kurosawa467/Smart-Glove-Control-System/Reports and Documents/Edge_Computing_Project_Interim_Demo.pdf

# Smart Glove Control System

### Team 2 - Ata Gün Öğün - Charles Donven - Yucong Ma

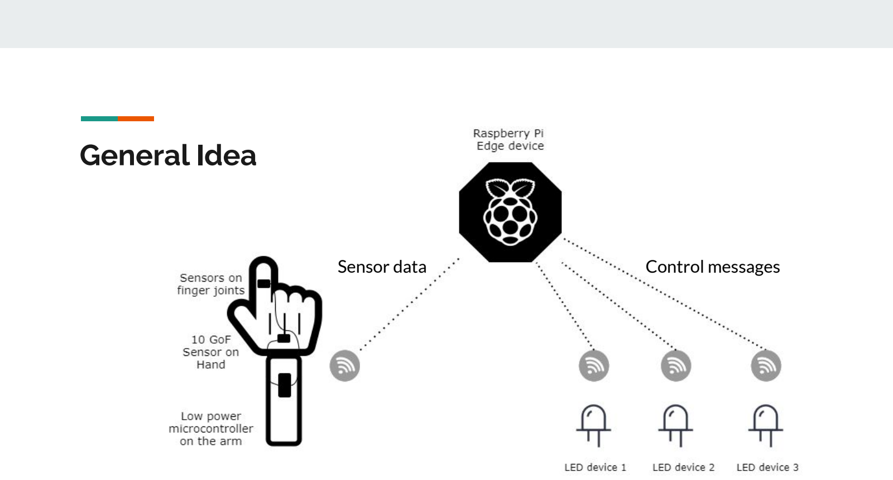
[picture p13: page 2]

Sensor data | Control messages

# General Idea

Cleaned up the code to better reflect the data flow we have in mind.

Implemented basic hard coded gestures for the demo.

Tested latency, fixed MQTT problems.

# What we have done

Implemented mock IoT LED devices which can receive commands via MQTT.

3D printed parts for mounting the flex sensors. Decided to sew them onto the glove instead.

Mounted the IMU to the glove internally, to avoid cutting the pins and doing solder work.

# 3D Printed Parts

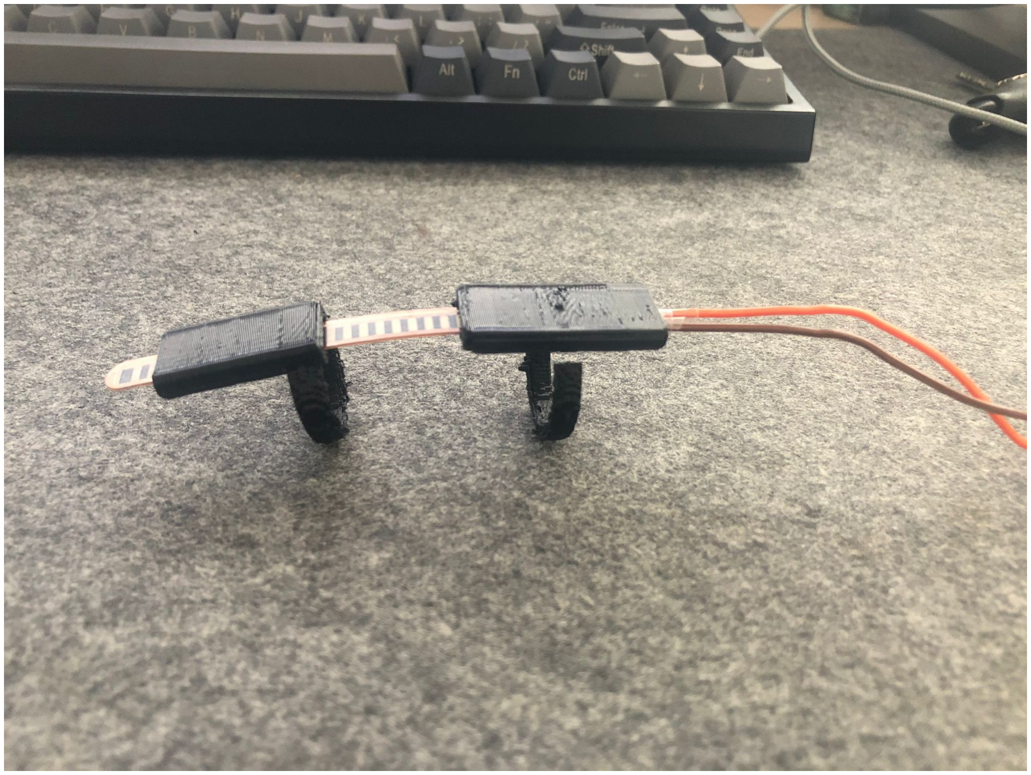
[picture p14: figure]

# Why we won’t use 3D Printed Parts

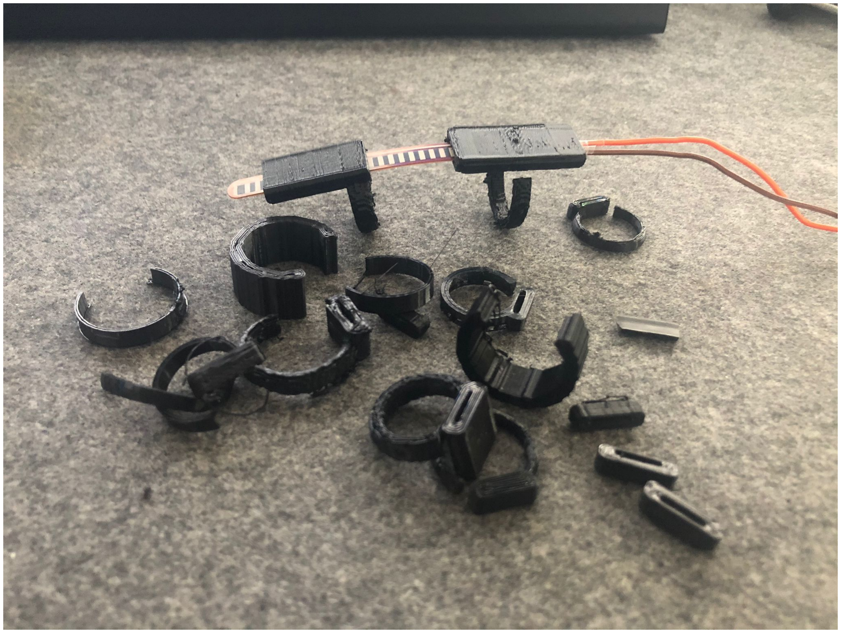
[picture p15: figure]

Most prints failed halfway.

Only one “successful” print after 9 tries.

Makes wearing the glove really complicated.

Uncomfortable to wear, restricts movement.

Harder to bend compared to our current design.

# Why we won’t use 3D Printed Parts

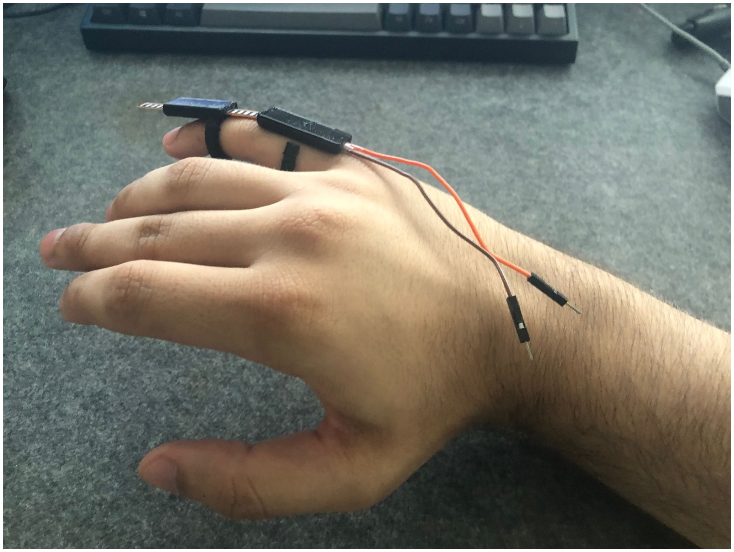
[picture p16: figure]

Most prints failed halfway.

Only one “successful” print after 9 tries.

Makes wearing the glove really complicated.

Uncomfortable to wear, restricts movement.

Harder to bend compared to our current design.

# Why we won’t use 3D Printed Parts

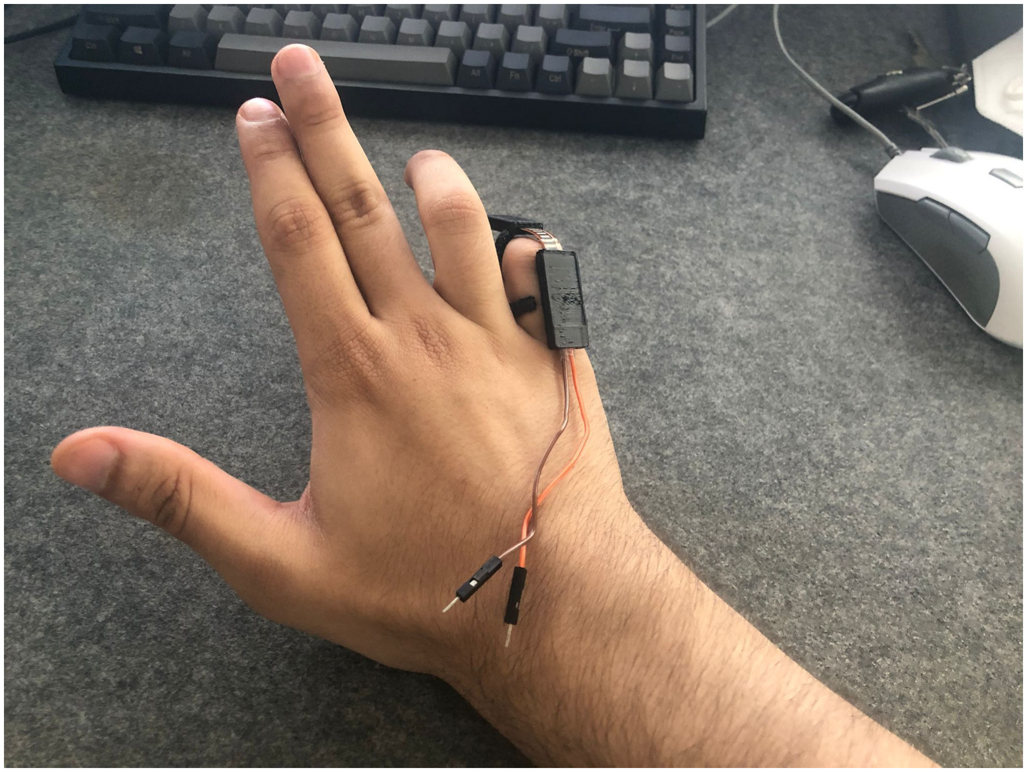
[picture p17: figure]

Most prints failed halfway.

Only one “successful” print after 9 tries.

Makes wearing the glove really complicated.

Uncomfortable to wear, restricts movement.

Harder to bend compared to our current design.

# Live demo

# Future work

Add a machine learning unit to process the commands coming from the glove

Add other devices to control

Generalize the method to add new objects to the system

# Thank you!

# Questions?
