kurosawa467/Smart-Glove-Control-System/Reports and Documents/Edge_Computing_Final_Presentation.pdf

# Smart Glove Control System

# Final Presentation

### Team 2 - Ata Gün Öğün - Charles Donven - Yucong Ma

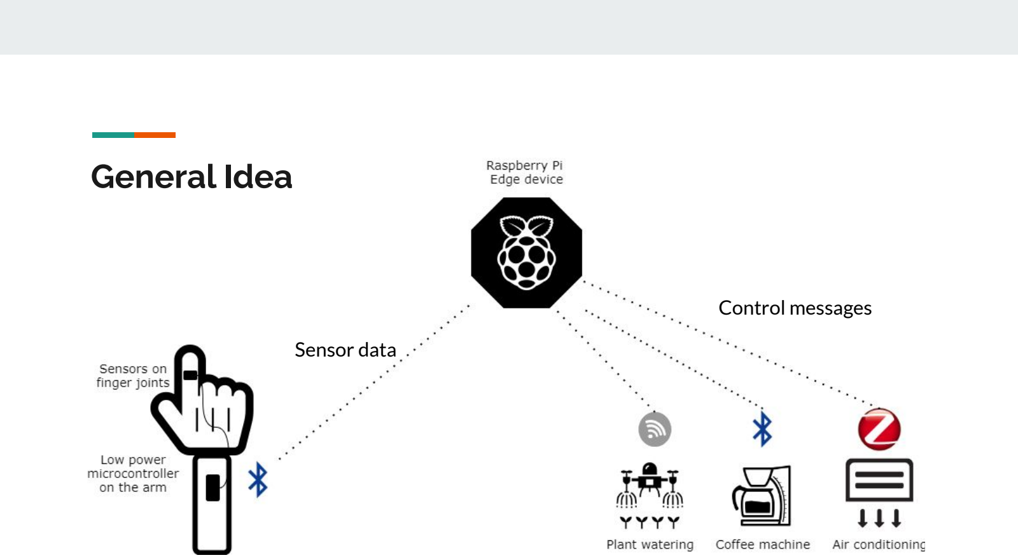
[picture p18: page 2]

# General Idea

Sensor data

Control messages

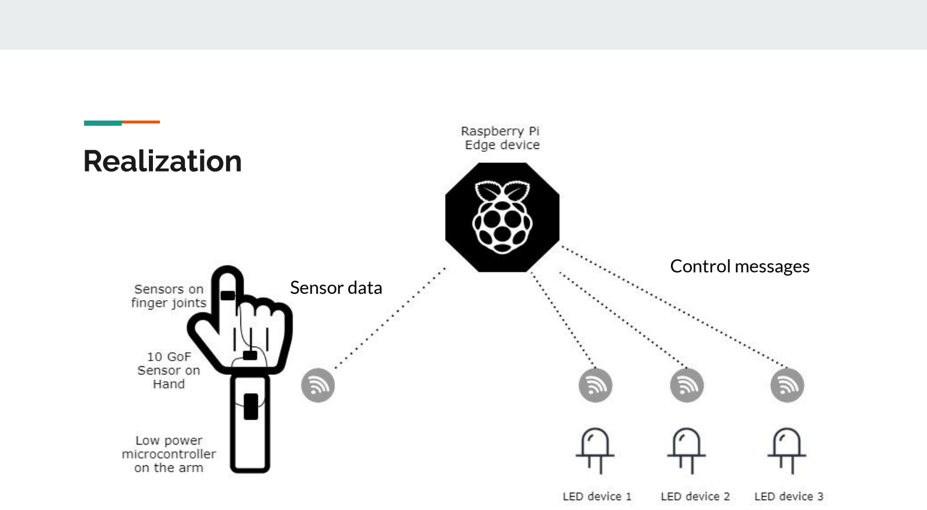
[picture p19: page 3]

# Realization

Sensor data

Control messages

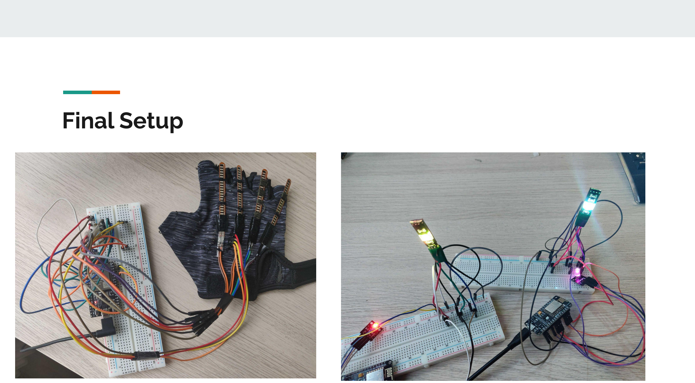
[picture p20: page 4]

# Final Setup

# Architecture Diagram

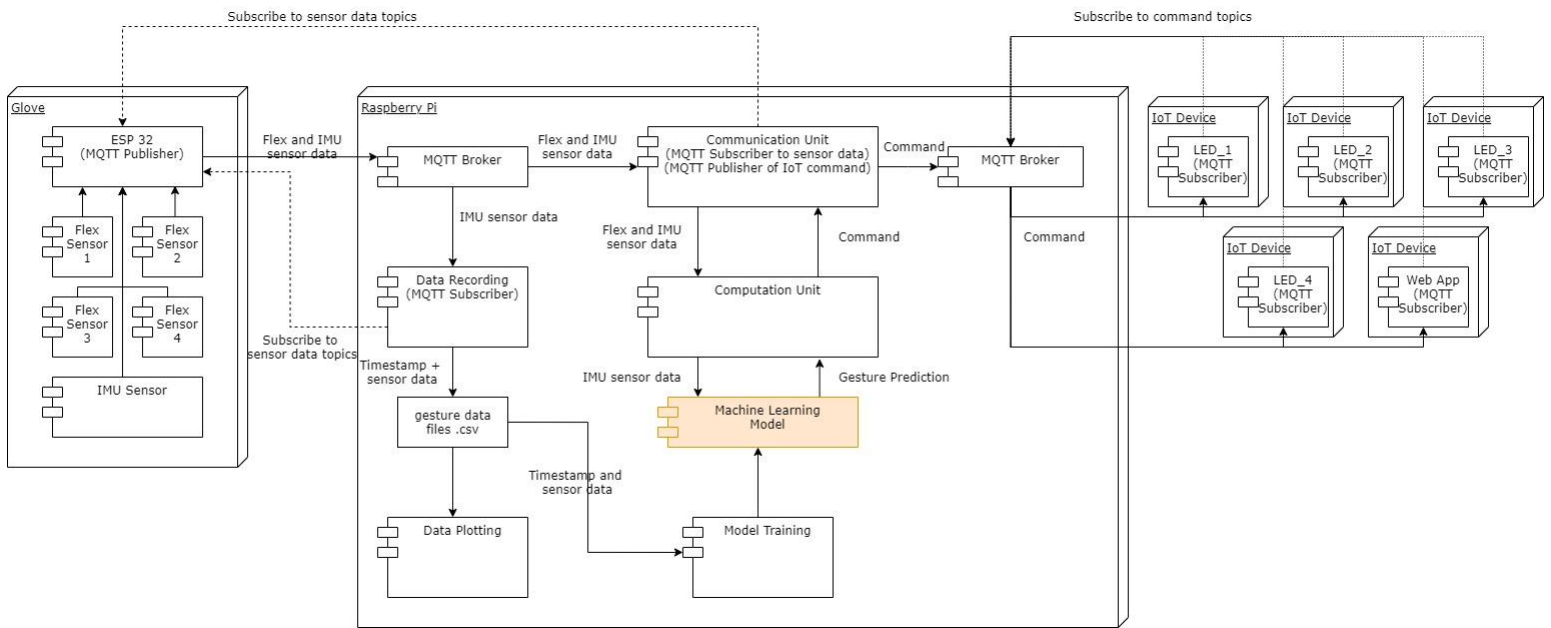
[picture p21: figure]

# Architecture Diagram: Application

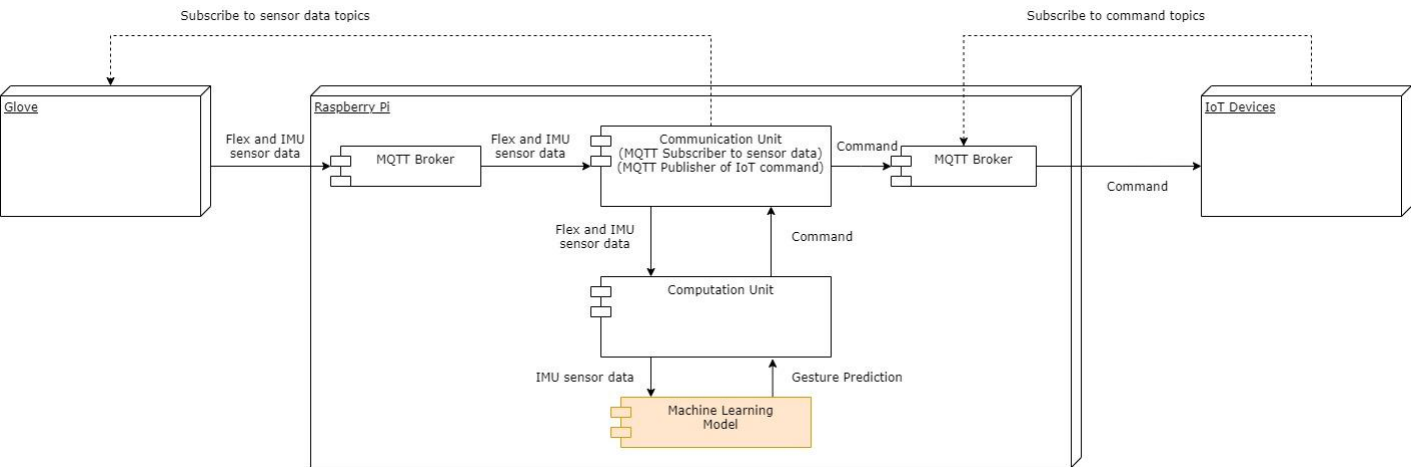
[picture p22: figure]

# Messaging Protocol: MQTT

- Publisher-Subscriber pattern, subject based
- Reliability
- Scalability

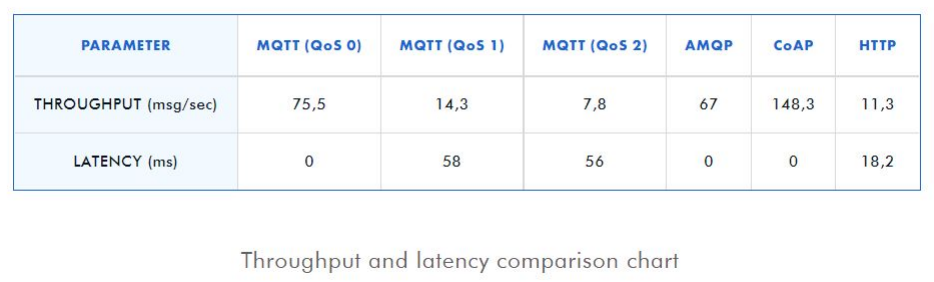
[picture p23: figure]

Source: Reasons and Peculiarities of Choosing MQTT Protocol for Your IoT Devices (2020.09.10), https://www.integrasources.com/blog/mqtt-protocol-iot-devices/ (https://www.integrasources.com/blog/mqtt-protocol-iot-devices/)

What has been done:

- Integrate IoT simulating web app to the program and display visual demonstrations based on commands.
- Recorded 5 gestures which are more intuitive (swipe left, swipe right, pull, clockwise, counterclockwise).

# Last Weeks Work

- Updated program workflow. Machine learning model is integrated into the original program and recognizes specific user gesture on the fly.
- Updated IoT devices so they can change their behavior on upcoming change request from the broker

# Machine Learning: Data Recording

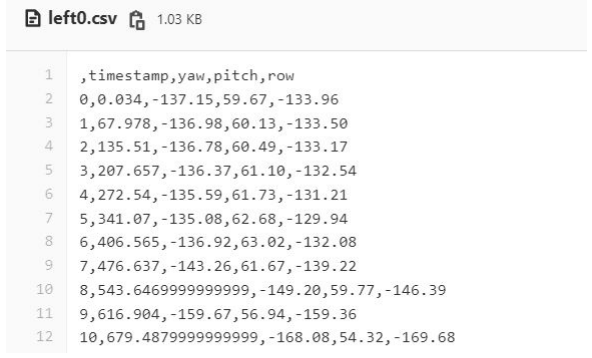
[picture p24: figure]

- Left, right, clock, pull
- 150 individual sets of data for each gesture

recorded for plotting model training

# Machine Learning: Data Plotting

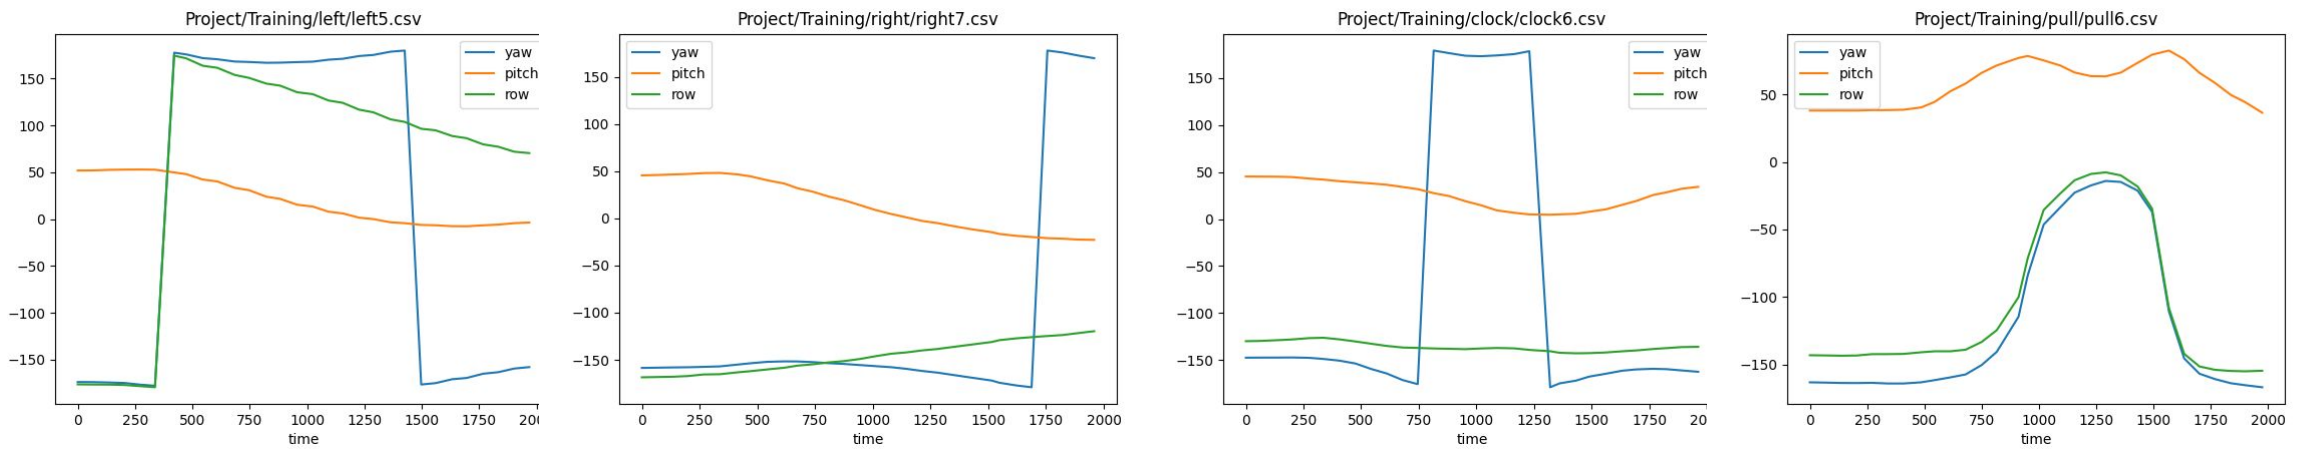
[picture p25: figure]
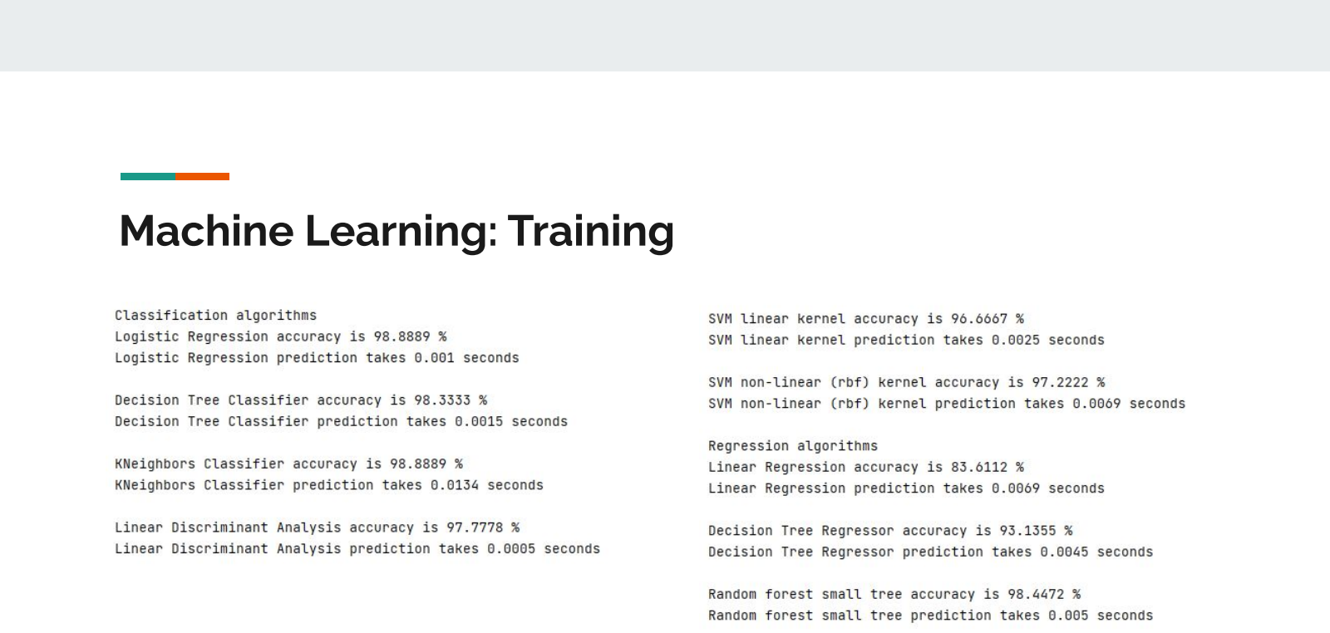
[picture p26: page 11]

# Machine Learning: Training

# Machine Learning: Live Testing

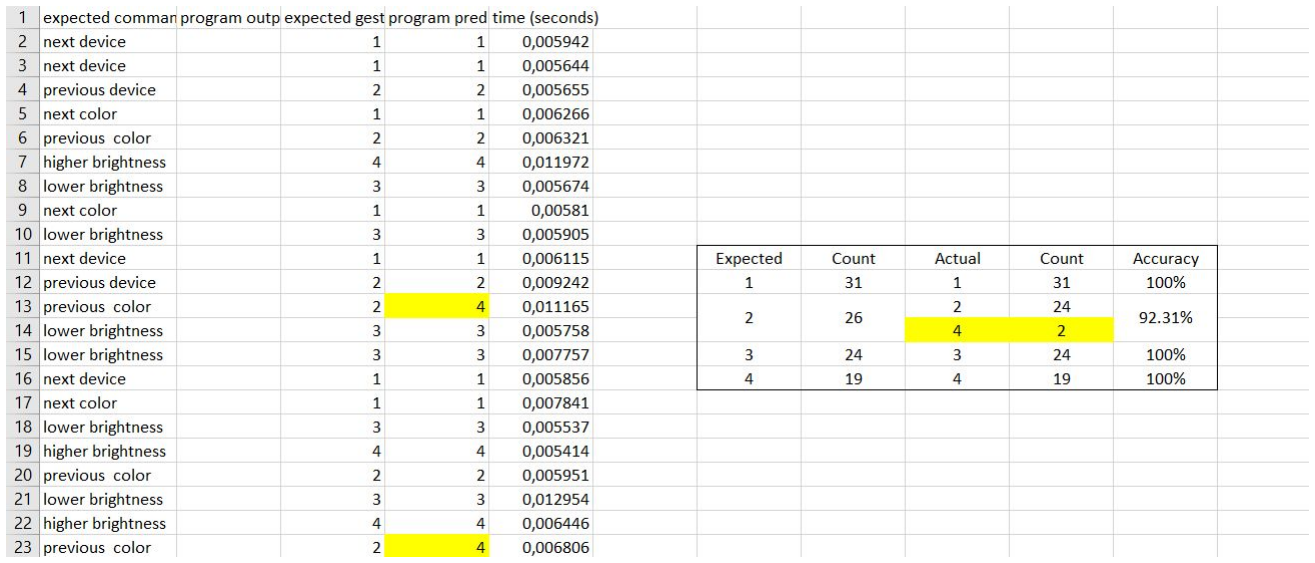
[picture p27: figure]

# Live Demo

# Future Improvement

- Flex-sensors did not work very well
- Sewing positions on the glove
- Hall effect sensors might work better
- More training data for machine learning model training
- Perform analysis and further data augmentation on the collected data
- Connect more IoT devices to the system
- Provide management portal for easy access to configuration

# Thank you!

# Questions?
