kurosawa467/Smart-Glove-Control-System/Reports and Documents/Edge_Computing_Sprint_3.pdf

# Smart Glove Control System

### Team 2 - Ata Gün Öğün - Charles Donven - Yucong Ma


# General Idea (recap)

Sensor data

Control messages

# Architecture Diagram


What has been done:

- Started working on several machine learning approaches.
- Implemented data collection to CSV files. Started developing an alternative data collection utility.
- Decided to write a desktop application, analogue to our IoT LED devices, to better show how the devices react to gestures during online presentations.

# Sprint 3 Recap

- Collected data for a single gesture and some noise. Trained a basic svm model to recognize that single gesture given a set of sensor data collected from both of the gesture and the noise.
- Refactored code, made data flow more clear.
- Added 2 more flex sensors to the glove, final version (some cable management/soldering later on, but no major changes expected)

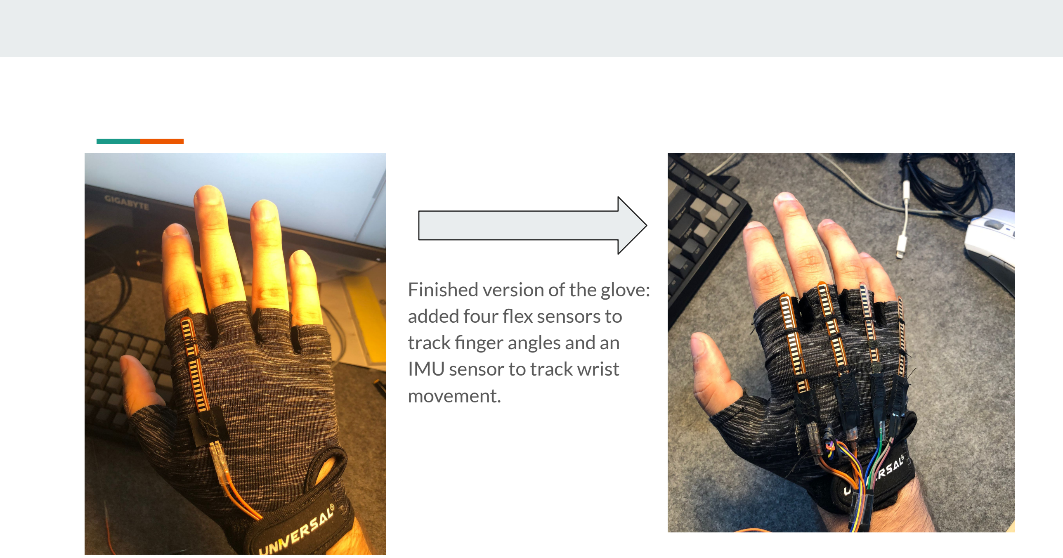
[picture p33: page 5]

Finished version of the glove: added four flex sensors to track finger angles and an IMU sensor to track wrist
movement.

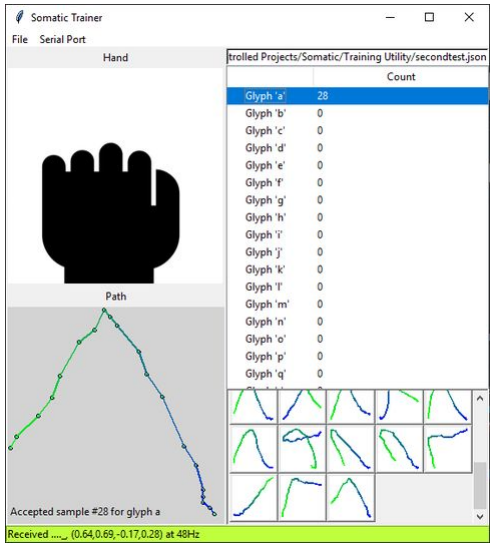
[picture p34: figure]

# Machine Learning

Found a discontinued, poorly documented, open source project for sensor data collection and model training.

Looks promising but uses defunct APIs, outdated libraries, hard coded for less dimensional sensor data, uses a different communication protocol, hard coded for specific hardware and more...

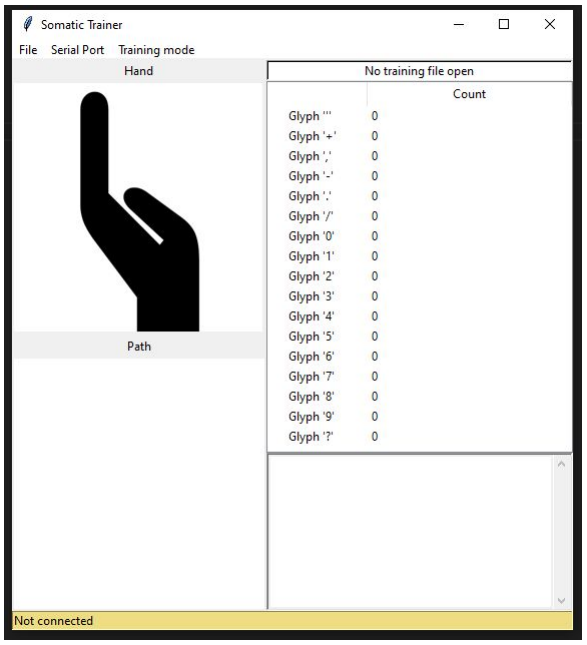
[picture p35: figure]

Fixing and reverse engineering the project to make it work with our glove.

Especially useful for data collection and visualisation.

Machine learning needs to be reimplemented from scratch.

# Machine Learning

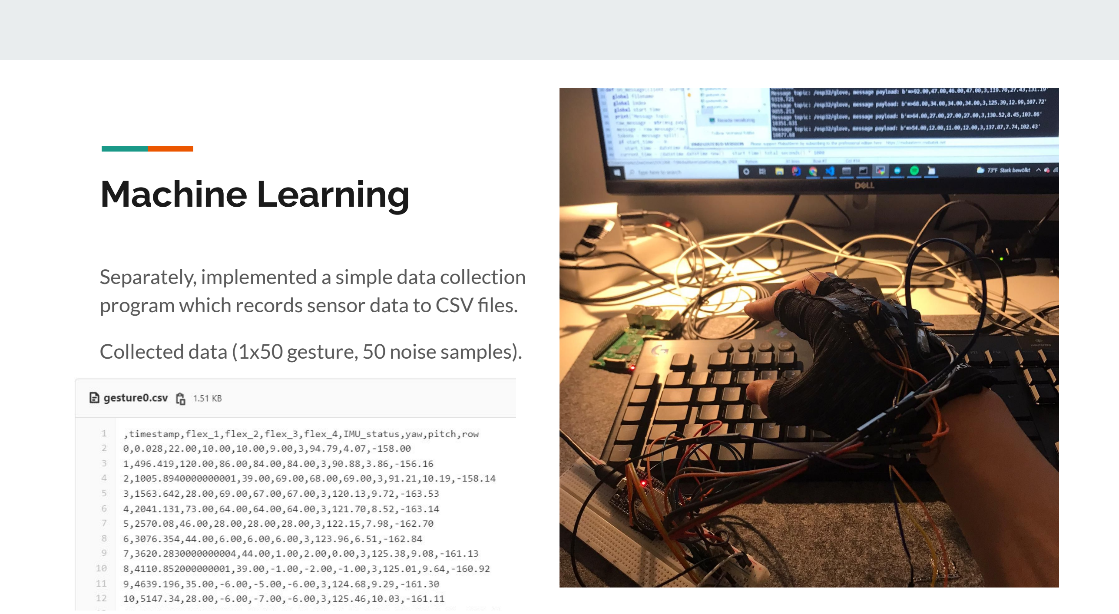
[picture p36: page 8]

# Machine Learning

Separately, implemented a simple data collection program which records sensor data to CSV files.

Collected data (1x50 gesture, 50 noise samples).

Our research suggests using Random Forest/XGBoost might be better for this kind of data.

(https://github.com/lwoiceshyn/Time-Series-Gest ure-Detection)

# Machine Learning

Tried using a basic SVM model for training. | Our research suggests using Random Forest/XGBoost might be better for this kind of data.
| (https://github.com/lwoiceshyn/Time-Series-Gest ure-Detection)

# Machine Learning

Machine Learning data recording and model training:

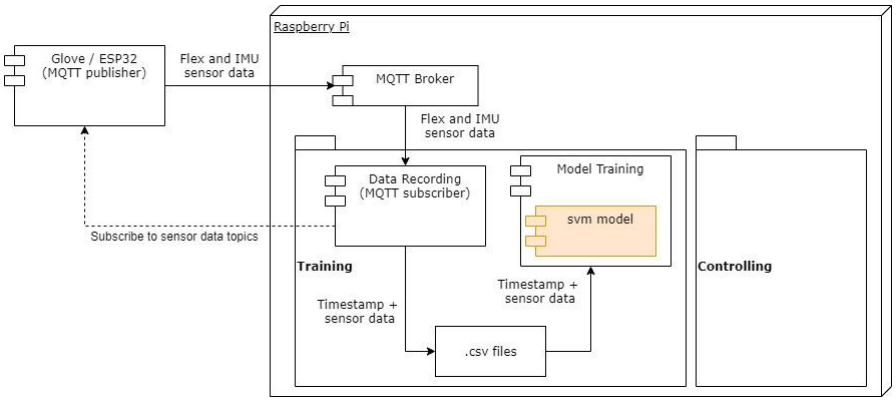
[picture p37: figure]

# Sprint 3 Recap

What was missed out:

Implement controlling part to process live gesture sensor data, and test out the model by interpreting live message sent from the glove and control the LEDs (integration test). Only training part is implemented using saved csv files.

# Sprint 4 Plan

- Improve data collection process.
- Data preprocessing to capture the most important features in the raw sensor data, and use those for model training instead.
- Write a desktop application, analogue to our IoT LED devices, to better show how the devices react to gestures during online presentations.
- Train using the most suitable machine learning framework/model.
- Integration test, which involves using the glove to send out sensor data - machine learning model interpret most likely gesture
- send out command to IoT devices

# Thank you!

# Questions?
