kurosawa467/Smart-Glove-Control-System/Reports and Documents/Edge_Computing_Sprint_4__2_.pdf

# Smart Glove Control System

### Team 2 - Ata Gün Öğün - Charles Donven - Yucong Ma

What has been done:

- Implement a web application which simulates an IoT device. We can use it for the demonstration.
- Refactored code structure.

# Sprint 4 Recap

- Recorded new gestures which are more intuitive (swipe left / right).
- Updated program workflow. Machine learning model is integrated into original program and recognizes specific user gesture on the fly.

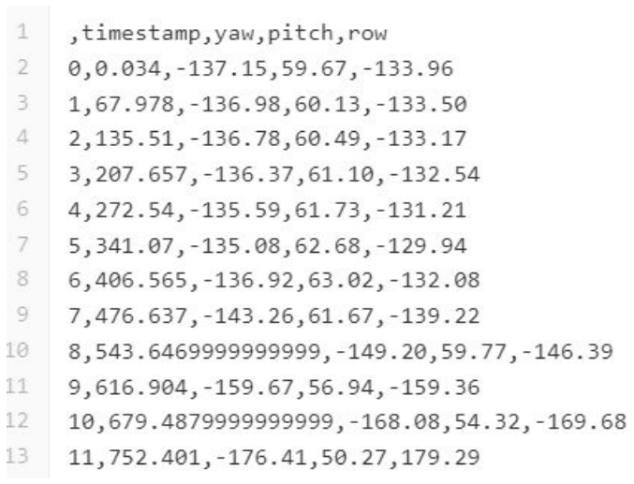
[picture p38: figure]

- Flex sensor data are used to specify controlling aspect (device or color)
- IMU sensor data (yaw, pitch, row) are used to capture gesture movement

# Machine Learning: Data Model

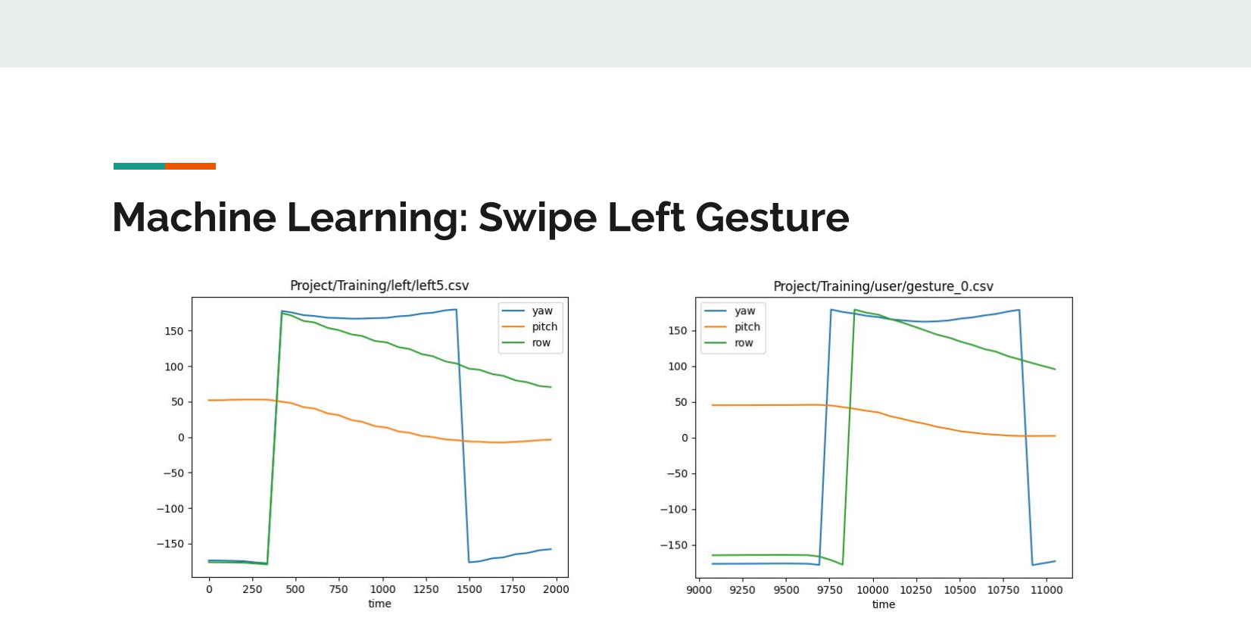
[picture p39: page 4]

# Machine Learning: Swipe Left Gesture

# Machine Learning: Swipe Left Gesture

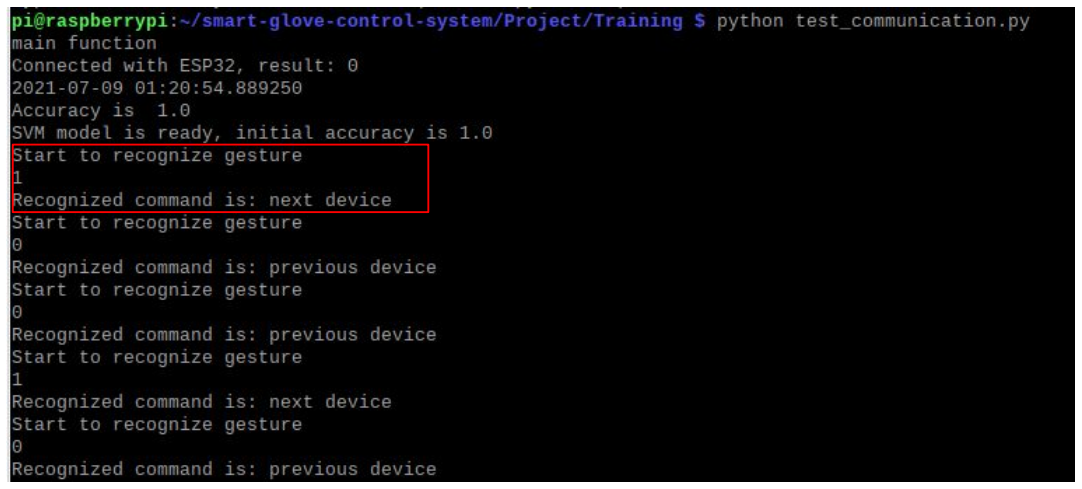
[picture p40: figure]
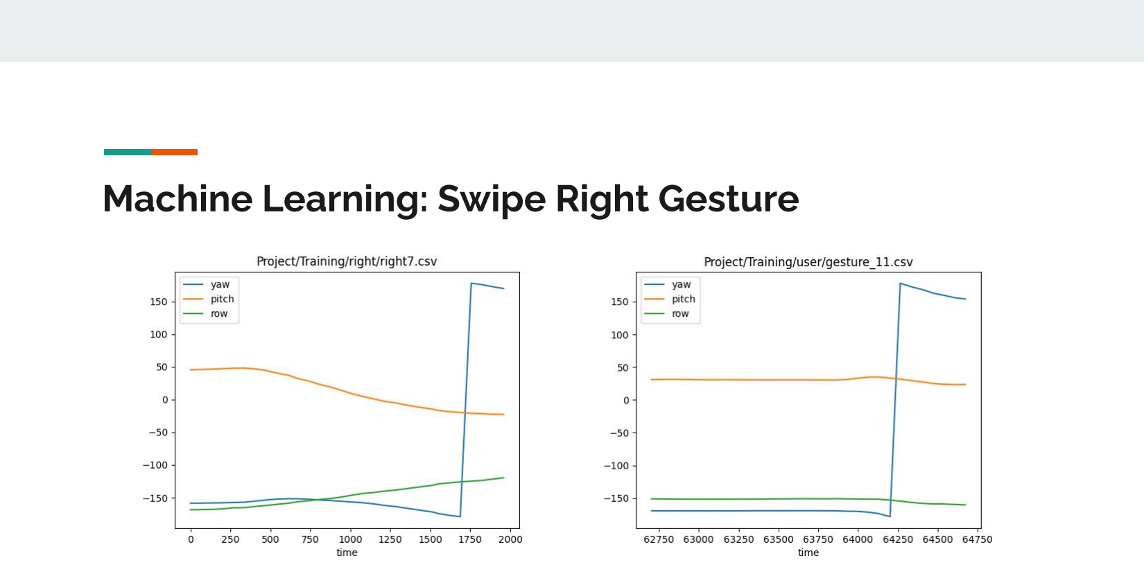
[picture p41: page 6]

# Machine Learning: Swipe Right Gesture

# Machine Learning: Swipe Right Gesture

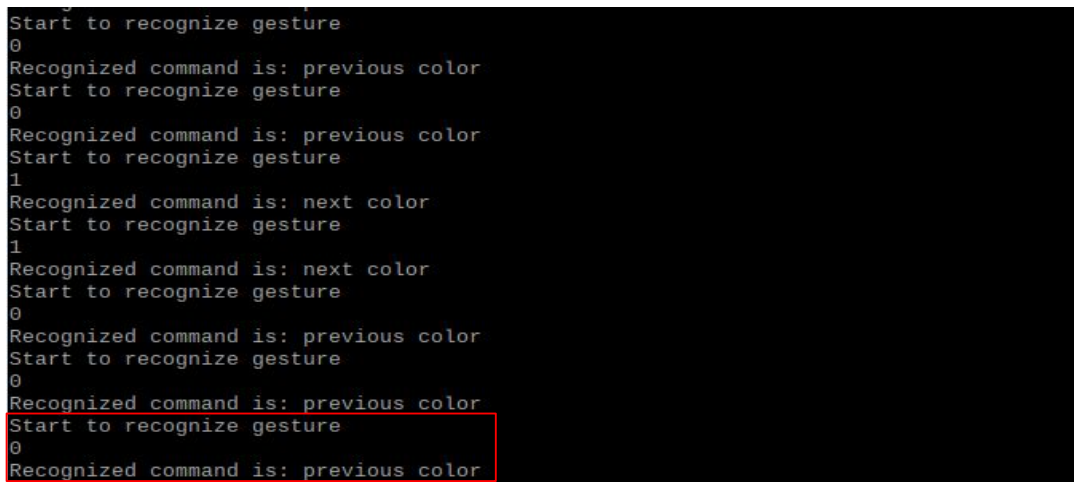
[picture p42: figure]
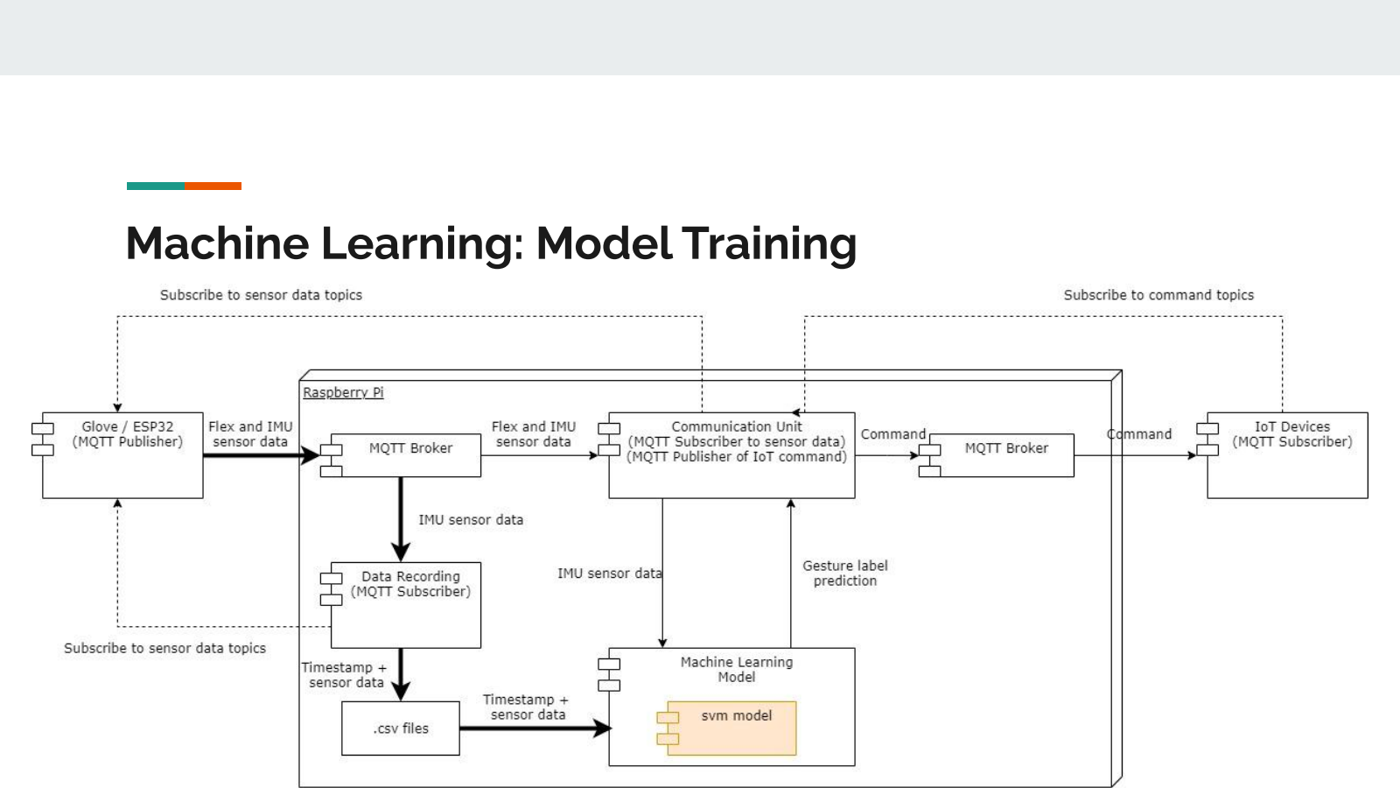
[picture p43: page 8]

# Machine Learning: Model Training

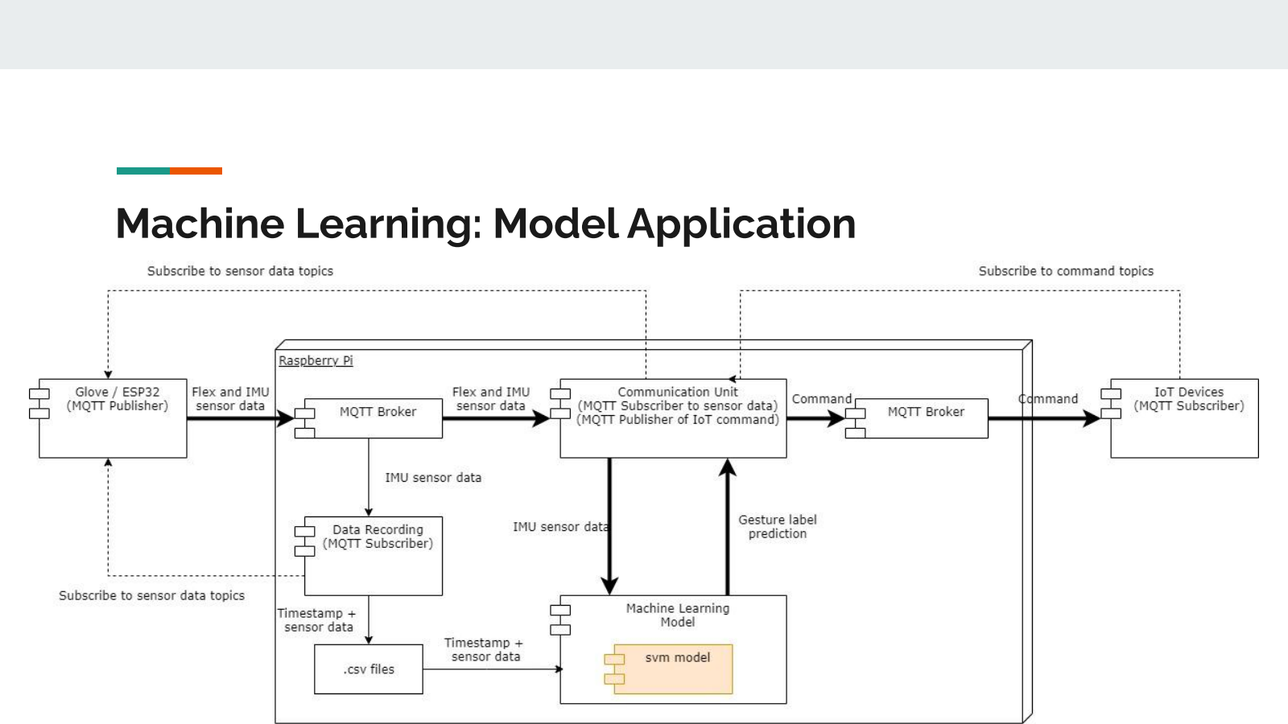
[picture p44: page 9]

# Machine Learning: Model Application

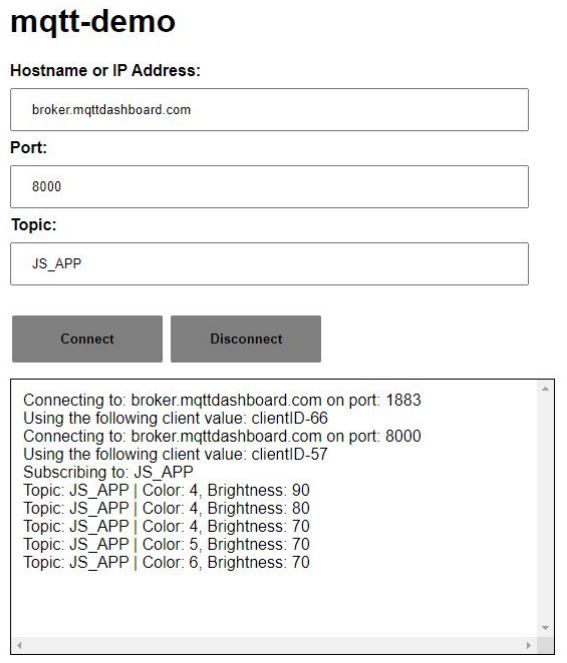
[picture p45: figure]

# WebApp

# Sprint 4 Result

What was missed out:

Given the time constraint, the machine learning data preprocessing (feature extraction) and a model switch from svm polynomial kernel to random forest were left out.

Performance tests were only conducted given correct gestures (left or right swiping). Tests of incorrect gestures were not included.

# Next week Plan

- Integrate IoT simulating web app to the program and display visual demonstrations based on commands.
- Test out random forest regression model and compare it with original svm polynomial kernel model.
- Test model prediction given incorrect / random user gestures. Give feedback when random gestures are recognized.
- Prepare for the demo

# Thank you!

# Questions?
