kurosawa467/Smart-Glove-Control-System/Project/Subscriber/mqtt_web_app/lightBuld.png

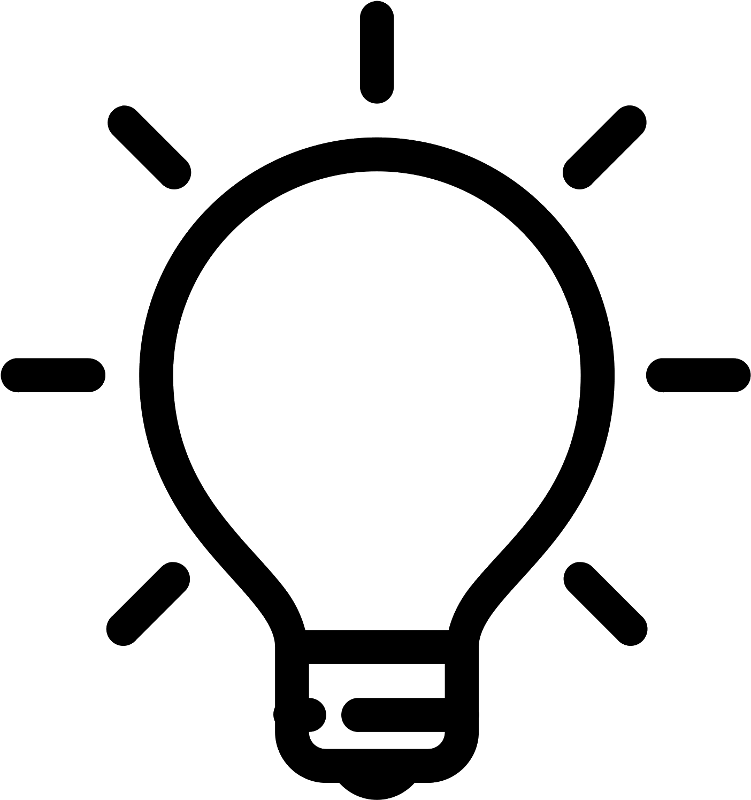
Project/Subscriber/mqtt_web_app/lightBuld.png
