kurosawa467/Smart-Glove-Control-System/Reports and Documents/2021-07-12-154507_1920x1080_scrot.png

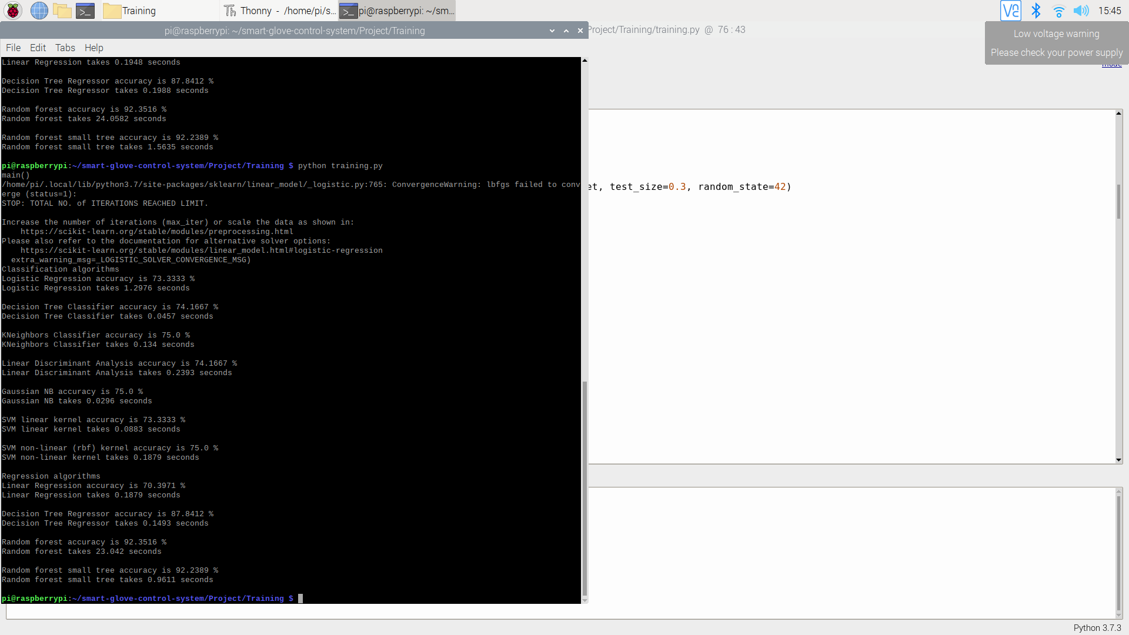
Reports and Documents/2021-07-12-154507_1920x1080_scrot.png
