kurosawa467/Smart-Glove-Control-System/Reports and Documents/2021-07-13-101529_1920x1080_scrot.png

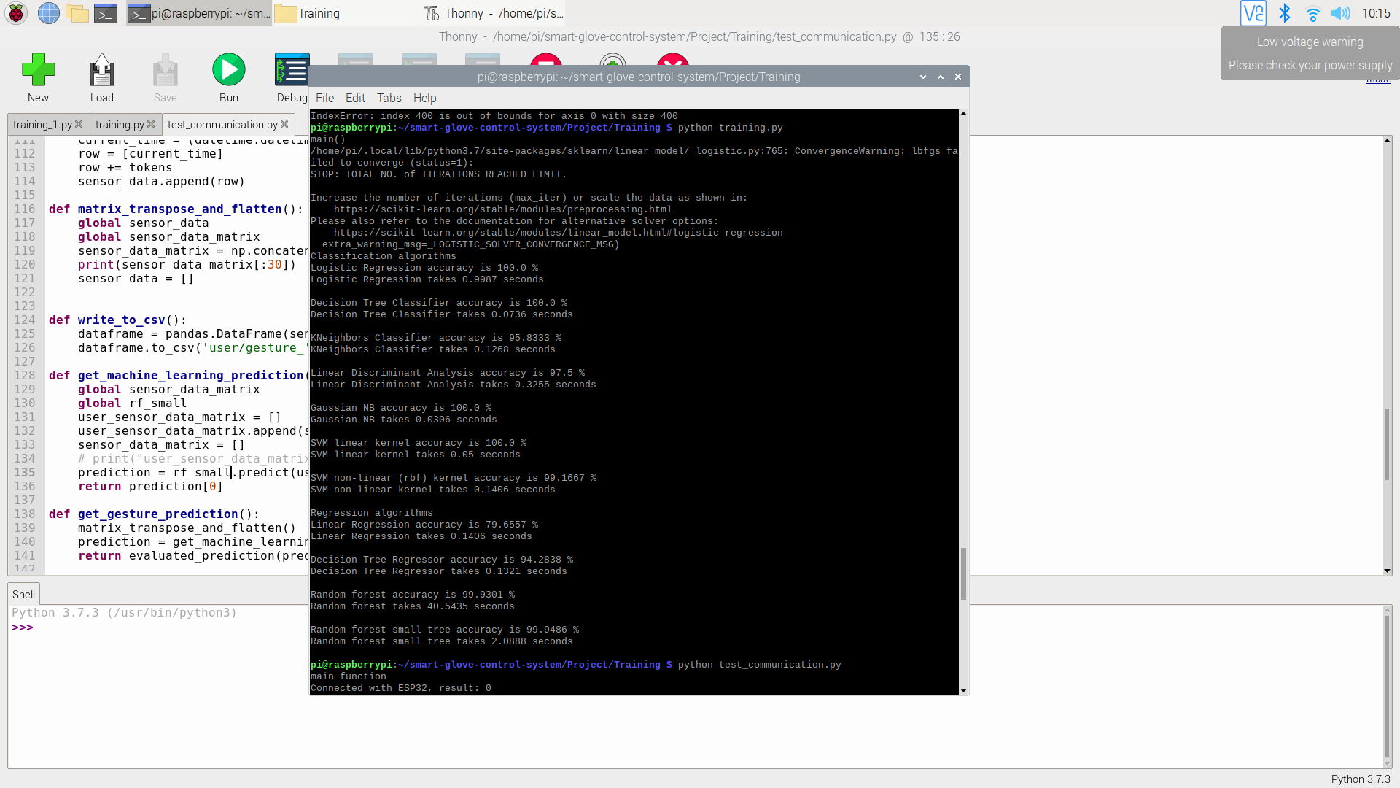
Reports and Documents/2021-07-13-101529_1920x1080_scrot.png
