kurosawa467/Smart-Glove-Control-System/Reports and Documents/Screenshot 2021-07-14 181841.png

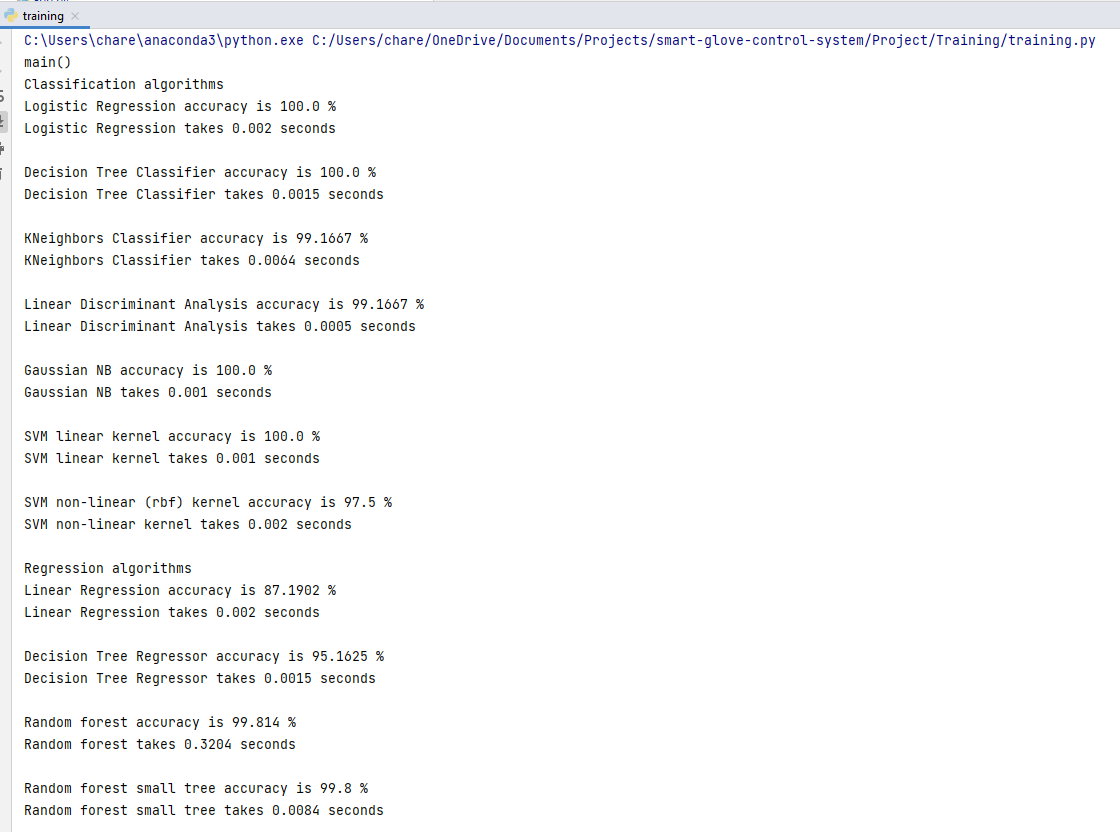
Reports and Documents/Screenshot 2021-07-14 181841.png
