kurosawa467/Smart-Glove-Control-System/Reports and Documents/Live_testings.xlsx

Sheet: rf
command (expected) | actual (program output) | gesture (expected) | prediction (program output) | accuracy | time (seconds)
next device | next device | 1 | 1.143 | 85.70% | 0.6027
next device | next device | 1 | 1.143 | 85.70% | 0.6425
previous color | previous color | 2 | 2 | 100.00% | 0.6296
higher brightness | higher brightness | 3 | 3.012 | 98.80% | 1.1301
gesture unrecognized | gesture unrecognized | && | 3.422 |  | 0.6396
higher brightness | higher brightness | 3 | 3 | 100.00% | 0.6289
gesture unrecognized | gesture unrecognized | && | 3.467 |  | 0.6103
previous color | previous color | 2 | 2 | 100.00% | 0.6204
previous device | previous device | 2 | 2 | 100.00% | 0.6313
previous color | previous color | 2 | 1.997 | 99.70% | 0.6312
next color | next color | 1 | 1.143 | 85.70% | 0.6256
higher brightness | higher brightness | 3 | 3.023 | 97.70% | 0.6285
lower brightness | lower brightness | 4 | 3.964 | 96.40% | 0.6237
gesture unrecognized | gesture unrecognized | && | 3.45 |  | 0.6219
next device | next device | 1 | 1 |  | 0.6251
previous device | previous device | 2 | 2 |  | 0.627
lower brightness | lower brightness | 4 | 3.948 |  | 0.6244
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
