kurosawa467/Smart-Glove-Control-System/(commit log)

2021-05-30 Updated flex sensor on the publisher side and new behaviors on the subscriber side
    [sketch_may30a.ino]
2021-06-04 Updated message token printout in the console
2021-06-04 python2 to 3 fix
    [app.py]
2021-06-04 python2 to 3 fix 2
    [app.py]
2021-06-04 implemented prototype glove, some tests, and v1 of the glove code for sending sensor data using MQTT
2021-06-07 Add dim response of the led
2021-06-07 Add information about wiring the led
2021-06-09 Updated LED brightness value
2021-06-09 Updated LED brightness
2021-06-09 update color control on led
2021-06-09 (probably) fixed the led issue
2021-06-10 change led unit to allow 2 leds
2021-06-10 two finger communication
2021-06-10 add 2 finger to the glove and the led module
2021-06-20 add test files for data collection
    [employee_file.csv]
2021-06-22 Uploaded 50 set of training data in csv
    [gesture0.csv, gesture1.csv, gesture10.csv, gesture11.csv, gesture12.csv, gesture13.csv, gesture14.csv, gesture15.csv]
2021-06-22 Added noise gesture sensor data tracking csv
    [noise0.csv, noise1.csv, noise10.csv, noise11.csv, noise12.csv, noise13.csv, noise14.csv, noise15.csv]
2021-07-07 Clean Repository
    [employee_file.csv, gesture0.csv, gesture1.csv, gesture10.csv, gesture11.csv, gesture12.csv, gesture13.csv, gesture14.csv]
2021-07-08 Updated training.py
    [gesture0.csv, gesture1.csv, gesture10.csv, gesture11.csv, gesture12.csv, gesture13.csv, gesture14.csv, gesture15.csv]
2021-07-09 Updated workflow and trained model
    [gesture_0.csv, gesture_1.csv, gesture_10.csv, gesture_11.csv, gesture_2.csv, gesture_3.csv, gesture_4.csv, gesture_5.csv]
2021-07-09 update broker for websocket
    [app.py]
2021-07-10 Add finger position determination logic
2021-07-10 fix finger value
2021-07-11 Uploaded left50.csv for testing
    [left50.csv]
2021-07-11 Recorded 20 sets of left swipe
    [left51.csv, left52.csv, left53.csv, left54.csv, left55.csv, left56.csv, left57.csv, left58.csv]
2021-07-11 Uploaded 83 sets of data for testing
    [clock0.csv, clock1.csv, clock2.csv, left65.csv, left70.csv, left71.csv, left72.csv, left73.csv]
2021-07-11 Added clockwise and counter-clockwise gesture sets
    [ccounter33.csv, clock10.csv, clock11.csv, clock12.csv, clock13.csv, clock14.csv, clock15.csv, clock16.csv]
2021-07-12 Added machine learning algorithms comparison
    [user0.csv, user1.csv, user2.csv, user3.csv]
2021-07-12 Recorded 4 user gestures for verification
    [user4.csv, user5.csv, user6.csv, user7.csv, user8.csv]
2021-07-12 Added user gestures for verification
    [user10.csv, user11.csv, user12.csv, user9.csv]
2021-07-13 Added two gestures for testing
    [user13.csv, user14.csv]
2021-07-13 Uploaded four gesture data sets
    [ccounter33.csv, user15.csv, user16.csv, user17.csv, user18.csv]
2021-07-13 Uploaded four gesture data set for testing
    [user19.csv, user20.csv, user21.csv, user22.csv]
2021-07-13 testing pull gesture
    [pull0.csv, pull1.csv, pull2.csv, pull3.csv]
2021-07-13 Testing new push gesture
    [pull0.csv, pull1.csv, pull10.csv, pull2.csv, pull3.csv, pull4.csv, pull5.csv, pull6.csv]
2021-07-13 Committed all updates
    [pull11.csv, pull12.csv, pull13.csv, pull14.csv, pull15.csv, pull16.csv, pull17.csv, pull18.csv]
2021-07-13 Testing circle and pull
    [user23.csv, user24.csv, user25.csv, user26.csv, user27.csv, user28.csv, user29.csv, user30.csv]
2021-07-13 Testing modified pull
    [user30.csv, user31.csv, user32.csv]
2021-07-13 Testing new pull gesture
    [pull0.csv, pull1.csv, pull10.csv, pull11.csv, pull12.csv, pull13.csv, pull14.csv, pull15.csv]
2021-07-13 Trained new pull gesture
    [pull0.csv, pull11.csv, pull12.csv, pull13.csv, pull14.csv, pull15.csv, pull16.csv, pull17.csv]
2021-07-14 Fix error message and test the timings capturing only the prediction
    [training.py]
2021-07-14 update models using correct sklearn version
    [test_communication.py]
2021-07-15 Update LED_device to change his status
2021-07-15 update treined models
    [ccounter33.csv]
2021-07-15 added digital led
2021-07-15 Revert "add command id to debug"
    This reverts commit 865e68e5162f35a9dd3db97f23c04900feb590d9.
    [LED_Device.ino, app.py]
2021-07-15 add gestures and new model
    [ccounter33.csv, clock100.csv, clock101.csv, clock102.csv, clock103.csv, clock104.csv, clock105.csv, clock106.csv]
2021-07-15 Recorded 80 new gestures
    [all_data.csv, clock110.csv, clock111.csv, clock112.csv, clock113.csv, clock114.csv, clock115.csv, clock116.csv]
2021-07-15 Added two datasets
    [user39.csv, user40.csv]
2021-07-16 80 more sets of data for training
    [clock130.csv, clock131.csv, clock132.csv, clock133.csv, clock134.csv, clock135.csv, clock136.csv, clock137.csv]
2021-07-16 Add show selected to the devices
2021-08-12 Upload New File
    [Live_testings.xlsx]
2021-08-12 change wrong RGB order
    [LED_Device.ino]
2021-08-12 add glove circuit
